fabianjuelich/ITS-150_Emulator/Attachements/analog_buttons.png

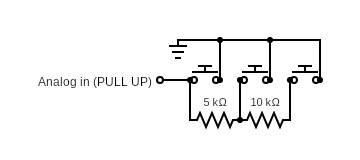
Attachements/analog_buttons.png
