fabianjuelich/ITS-150_Emulator/main/main.ino

#include "signal.h"
#include <RCSwitch.h>

#define KEYS_ANAL A0
#define KEYS_DIGI 2
#define RF_TRANS  4

char keys[] = {'A', 'B', 'C'};
short keys_val[] = {0, 150, 300};
short keys_func[] = {1, -1, 0};
unsigned long last_time = 0;
RCSwitch mySwitch = RCSwitch();

void setup() {
  // Setup pins
  pinMode(KEYS_ANAL, INPUT_PULLUP);
  pinMode(KEYS_DIGI, INPUT);

  //Serial.begin(115200);

  // Setup RCSwitch
  mySwitch.enableTransmit(RF_TRANS);
  mySwitch.setRepeatTransmit(6);

  // Setup interrupt
  attachInterrupt(digitalPinToInterrupt(KEYS_DIGI), isr, FALLING);
}

void loop() {
  /* go to sleep */
  ADC_Enable(0); // disable ADC
  // Setup deep sleep (Power-down mode)
  SMCR |= 1<<2; // mode 2
  SMCR |= 1; // sleep enable
  __asm__ __volatile__("sleep"); // inline assembly for setting to sleep
  /* wakes up */
  adc();
  delay(500);
}

void adc() {
  if (((micros() - last_time) < 250000) && last_time != 0) return;
  ADC_Enable(1);
  short digi = analogRead(KEYS_ANAL);
  //float anal = (float(digi)/1024) * 5;
  short epsilon = pow(2, 10);
  char key;
  for (char k=0; k<(sizeof(keys)/sizeof(char)); k++) {
    short tmpEpsilon = abs(keys_val[k]-digi);
    if (tmpEpsilon < epsilon) {
      epsilon = tmpEpsilon;
      key = k;
    }
  }
  last_time = micros();
  //Serial.println(last_time);
  //Serial.println(digi);
  //Serial.println(keys[key]);
  //delay(500);
  if (keys[key] == 'A' || keys[key] == 'C') sendSignaltoAll(keys_func[key], mySwitch);
  else if (keys[key] == 'B') custom(mySwitch);
}

void ADC_Enable(bool val) {
  if (val) ADCSRA |= 1<<7;
  else ADCSRA &= ~(1<<7);
}

void isr() {}
