fabianjuelich/ITS-150_Emulator/main/command.h

extern long commands[4][2][4]; // [I, II, III, IV] [ON/OFF] [1, 2, 3, 4]

// codes.cpp example
/*
long codes[4][2][4] = {
  {
    {
      1234, 2345, 3456, 4567
    },
    {
      ...
    }
  },
  {
    ...
  },
  ...
}
*/
