fabianjuelich/ITS-150_Emulator/(commit log)

2023-08-12 Change data pin
2023-08-13 Edit circuit diagram
2023-08-30 Fix deep sleep and timer
    [main.ino]
